ViktorSmirnov71/dough-proofer/W1_buttons_lcd/schematic.png

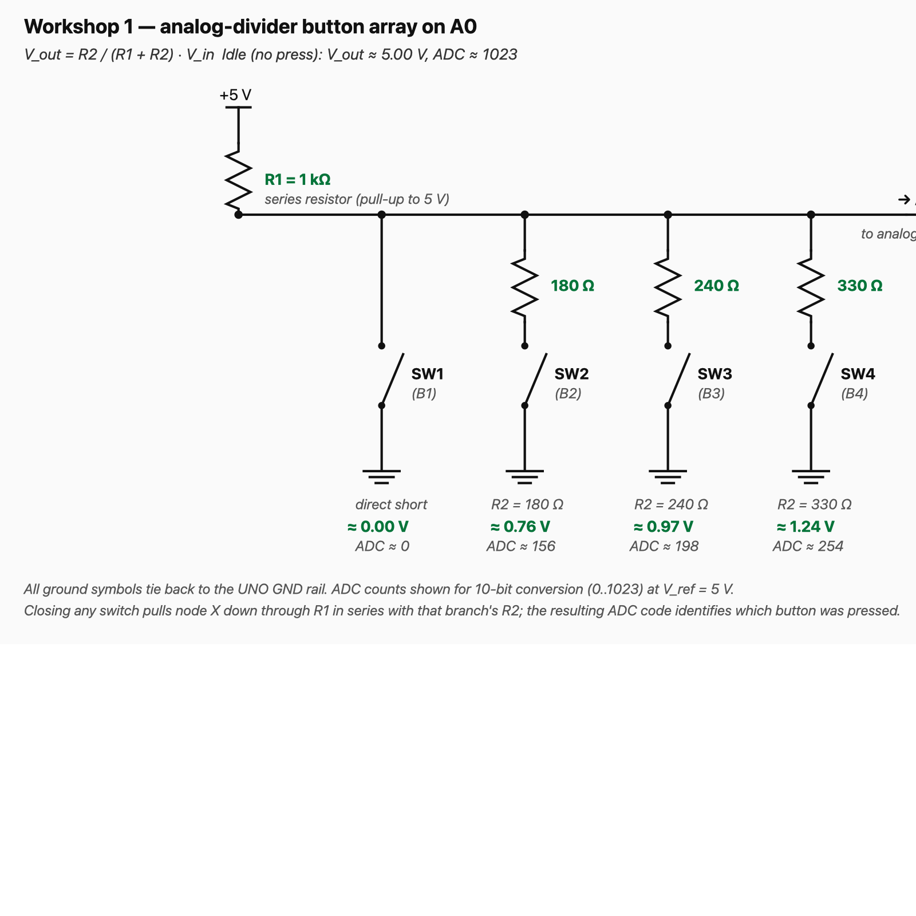
W1_buttons_lcd/schematic.png
