ViktorSmirnov71/dough-proofer/(commit log)

2026-05-11 Initial sketch: button divider on A0 + Grove RGB LCD
    Four push-buttons share a single analog pin via a 1k series resistor and
    three switched ground-leg resistors (180/240/330R). The sketch classifies
    each press from the resulting ADC code using slide-deck-derived thresholds,
    debounces with 5ms x 6 stable samples, and emits idle->press edges only.
    LCD shows the current setpoint and a press counter; 'c' on serial prints
    the live raw A0 value for band-table calibration.
    Includes WIRING.md and a hand-drawn SVG/PNG schematic of the divider.
2026-05-11 Add two-page proofer UI: TEMP + HUMIDITY modes
    MODE (B2) cycles between a TEMP page (live temp + editable setpoint via +/-)
    and a HUM page (humidity, read-only). STOP (B1) resets all state.
    Backlight goes warm amber on TEMP, cool cyan on HUM -- a glance tells you
    which page is active without reading the text.
    Readings are stubbed (marked with * on the LCD) by a first-order temp
    relaxation toward the setpoint and a deterministic +/-3% humidity sine
    wave on a 30 s period. stepSimulation() is the seam where real sensors
    will plug in.
    Also adds 'v' verbose stream that runs each sample through the same
    classifier as the press-edge logic, so holding a button continuously
    reports 'thinks=MODE' et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
    [W1_buttons_lcd.ino]
2026-05-11 Add HEIGHT mode using Grove Ultrasonic Distance Sensor v2
    Third LCD page tracks dough rise. The sensor's single-wire protocol
    (bidirectional signal pin: pulse HIGH to trigger, then read INPUT for
    echo width) is implemented inline -- no external library, ~30 lines
    including the speed-of-sound conversion and 30 ms timeout cap.
    Entering the HEIGHT page auto-tares the baseline at the current reading
    so the display starts at +0 mm and climbs as the dough rises. B3 re-tares
    on demand if the start was wrong (e.g. the jar got moved).
    Adds two diagnostic serial commands: 'p' fires a single ping and dumps
    every observable (idle line state, raw pulseIn microseconds, elapsed
    time, post-ping line state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
    [W1_buttons_lcd.ino]
2026-05-11 Replace temperature/humidity stubs with DHT22 reads
    Pulls a Grove Temperature & Humidity Sensor Pro v1.3 (DHT22) in on D4.
    Uses Adafruit's DHT library for the proprietary 1-wire-style protocol.
    stepSimulation() becomes stepSensors() with two independent timers --
    sonar at 1 Hz (cheap, pulseIn caps at 30 ms), DHT22 at 0.4 Hz (datasheet
    minimum is 2 s between reads). The DHT can intermittently return NaN
    when its internal sampling collides with our poll; we just hold the
    previous good value rather than corrupting the display.
    A dhtValid flag suppresses the first-render numeric output and shows
    '--.- ' on the LCD until a real reading lands, so the operator never
    mistakes a stale stub for live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
    [W1_buttons_lcd.ino]
2026-05-11 Document the project: scientific README + operation manual
    Rewrites the top-level README around the experimental motivation
    (yeast fermentation as a slow autocatalytic reaction with strong
    temperature and humidity sensitivity), the design choices made for
    the embedded side (single-ADC button matrix, single-wire Grove
    sensors, two-rate sampling), and a concrete roadmap for the
    control-loop and forecasting work still ahead.
    Adds MANUAL.md as the day-to-day cheat sheet: compile/upload paths,
    serial-monitor format, button mapping, the 'c' / 'v' / 'p' / 'd'
    diagnostic commands, a 60-second health check that proves debouncing
    and edge-triggering work, and a runtime-issues table.
2026-05-11 HEIGHT page shows raw distance by default, tare on demand
    Auto-tare on mode entry was capturing whatever the sensor saw at that
    instant -- typically the ceiling or a wall a metre away -- and any
    subsequent reading then displayed as a huge positive 'rise'. Confusing.
    New behaviour:
    - Line 1 always shows the raw distance in mm.
    - Line 2 prompts 'B3 to tare' until the user explicitly sets a baseline.
    - Once tared, line 2 switches to the signed rise from baseline.
    STOP (B1) still clears the baseline, so the next entry to HEIGHT starts
    in the untared state again.
2026-05-11 Close the temperature loop: bang-bang heater on D8
    Adds active control of a Grove relay driving a silicone heater pad,
    turning the panel from a passive monitor into a real controller.
    Controller is bang-bang with a 0.5 C deadband around the setpoint --
    narrow enough to hold within +/-1 C on a slow thermal mass, wide enough
    that DHT22 sensor noise (~0.1 C tick-to-tick) does not chatter the
    relay. Two safety interlocks: the relay opens unconditionally if the
    chamber reads above 45 C (sensor fault or runaway), and refuses to
    close at all until the DHT22 has produced a valid reading (no blind
    heating). Both setpoint edits and DHT samples re-evaluate the heater
    state, so user input takes effect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
    [W1_buttons_lcd.ino]
2026-05-11 Add Grove speaker on D5 with VOLUME page
    The piezo speaker is wired into the firmware as an audio annunciator.
    It cannot synthesise speech (square-wave tones only), so the current
    chamber metric is announced using beep-count encoding:
    tens digit at 500 Hz, pause, units digit at 1200 Hz, zero marked by
    a single short low blip.
    Distance values are first scaled mm -> cm so they fit the two-digit
    envelope. Sensor faults produce a 500 ms 120 Hz growl that is hard to
    miss.
    MODE press now announces the value of the page it just landed on,
    so cycling through TEMP / HUM / HEIGHT is a hands-off audio sweep
    of the chamber state. The 's' serial command re-plays the announcement
    on demand.
    Adds MOD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
    [W1_buttons_lcd.ino]
2026-05-11 Speech via R4's 12-bit DAC on A0 (TalkiePCM)
    Hardware swap: button matrix moves from A0 to A1, speaker moves from D5
    to A0. The whole reason for the swap is that A0 is the UNO R4 WiFi's
    only true analogue DAC pin -- everything else does PWM, which puts a
    ~490 Hz carrier inside the audio band and makes intelligible speech
    impossible without an external low-pass filter.
    Firmware changes that follow:
    - PIN_BUTTONS = A1, PIN_AUDIO = A0.
    - TalkiePCM linked in. A small dacCallback() converts each int16 sample
    to a 0..4095 DAC code and clocks it out at ~8 kHz via a busy-wait.
    The Renesas core routes analogWrite(A0, ...) through the DAC when
    resolution is 12-bit, bypassing PWM entirely.
    - be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
    [W1_buttons_lcd.ino]
2026-05-11 Tune DAC sample timing for TalkiePCM speech
    The previous dacCallback used delayMicroseconds(125) between samples,
    which assumes analogWrite + LPC math cost zero time. They don't:
    analogWrite to the DAC takes ~30 us and the vocoder's LPC filtering
    adds another 20-100 us per sample, so the effective rate sagged to
    5-6 kHz instead of the 8 kHz the library generates samples for. The
    output sounded like a long random buzz because the playback was both
    the wrong rate AND varying with vocoder workload.
    Switching to absolute-time scheduling via micros() and an explicit
    nextSampleUs counter: each iteration waits until its scheduled slot
    instead of adding a fixed delay, so long iterations get absorbe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
    [W1_buttons_lcd.ino]
2026-05-11 Make TalkiePCM speech audible: gain hooked to VOLUME page
    Diagnostic confirmed the audio path is fine -- DAC writes were happening
    at the right rate with proper sample variation, ~25 % swing around
    midpoint. The speech was simply quieter than the earlier 1 kHz test
    tone, which ran at full DAC rail. The LM386 amplifier in the Grove
    Speaker passes both equally well; the test tone was just louder going
    in.
    Wires TalkiePCM's internal volume control into the VOLUME page:
    level 1 -> setVolume(0.6f) -- noticeably quieter
    level 2 -> setVolume(1.2f) -- gentle boost since raw LPC output only
    uses ~25 % of DAC range
    level 3 -> setVolume(1.8f) -- accepts some peak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
2026-05-11 Overdrive TalkiePCM gain so speech matches beep loudness
    Diagnostic showed valid speech samples were reaching the DAC but only
    swung ~25 % of the rail, while system beeps drive full rail. At the
    speaker's pot setting that made beeps audible the speech sat below
    the noise floor. Pushing TalkiePCM's setVolume aggressively per level:
    level 1 -> 1.0x (raw LPC amplitude -- legibly quiet)
    level 2 -> 2.5x (saturates int16 on peaks, perceived as clearly
    audible; the LPC envelope still survives)
    level 3 -> 5.0x (hard clipping -- waveform becomes near-square,
    speech sounds heavily distorted but unmistakable
    in a noisy room)
    Practic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
    [W1_buttons_lcd.ino]
2026-05-12 Rebrand to isotherm-r4 and add diagram-rich README
    Drops the dough/proofing framing in favour of a generic isothermal
    reaction-chamber instrument. Adds docs/{control_loop,system_block,
    pinout}.svg, a Mermaid state diagram for the operator modes, a tunable-
    constants table, and pointers to the Fritzing + Seeed Grove parts
    toolchain for anyone wanting to extend the diagrams.
